Nemus-Project/harpsichord-interface/img/disegno.pdf

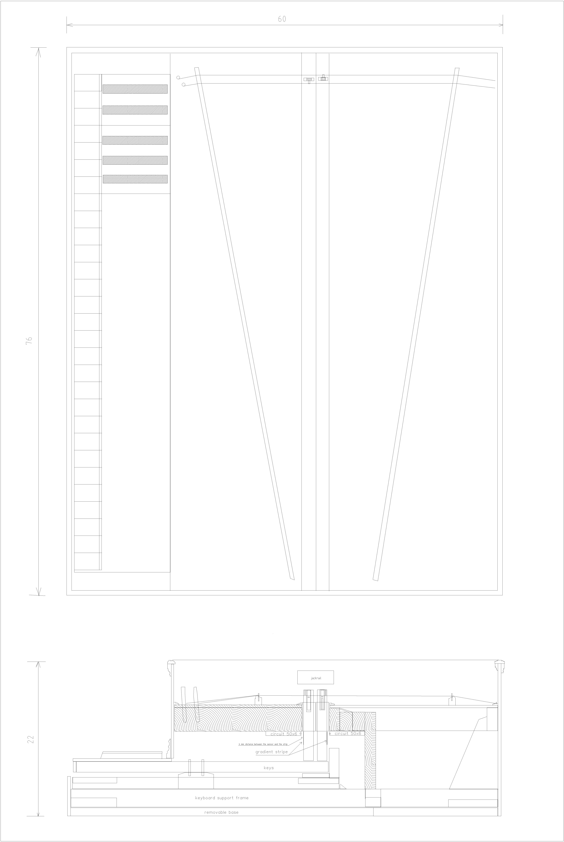
[picture p6: page 1]
