Nemus-Project/harpsichord-interface/docs/img/controller_board.png

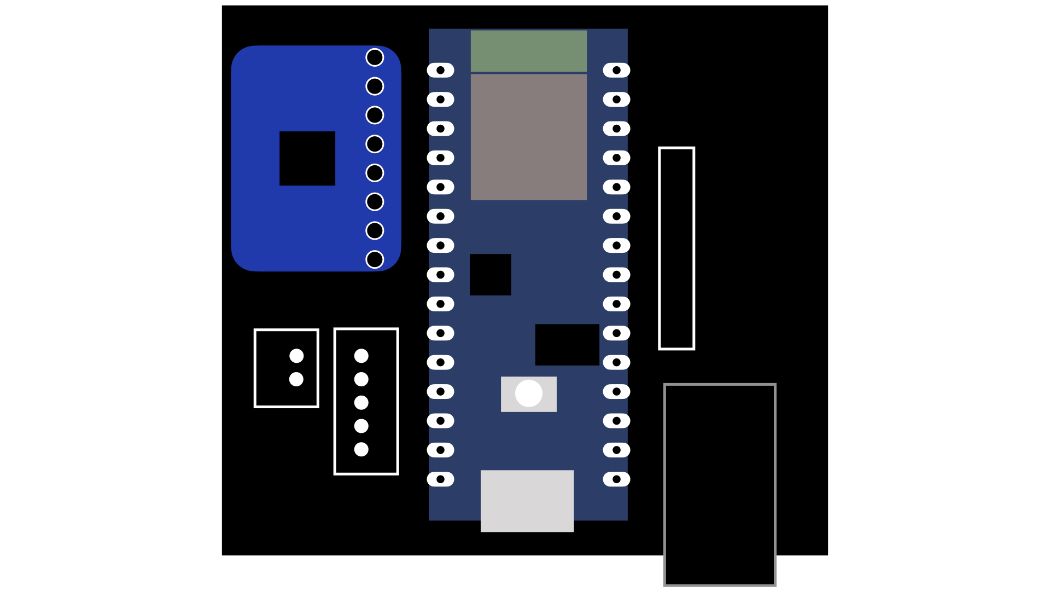
docs/img/controller_board.png
