Nemus-Project/harpsichord-interface/img/7-jack-pcb.jpeg

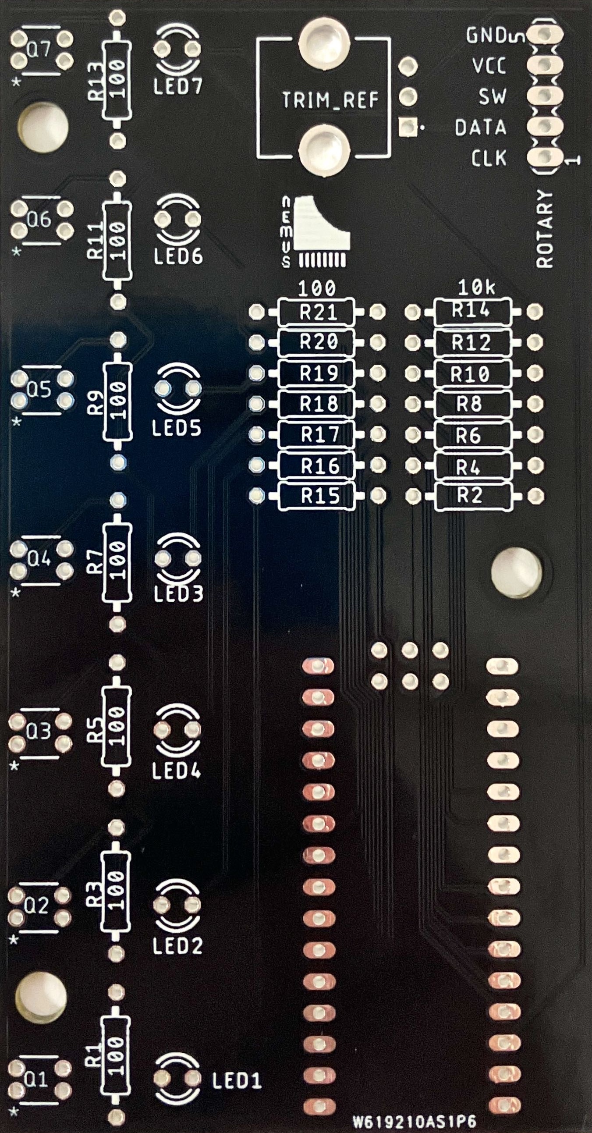
img/7-jack-pcb.jpeg
