Nemus-Project/harpsichord-interface/img/7-jack-pcb.png

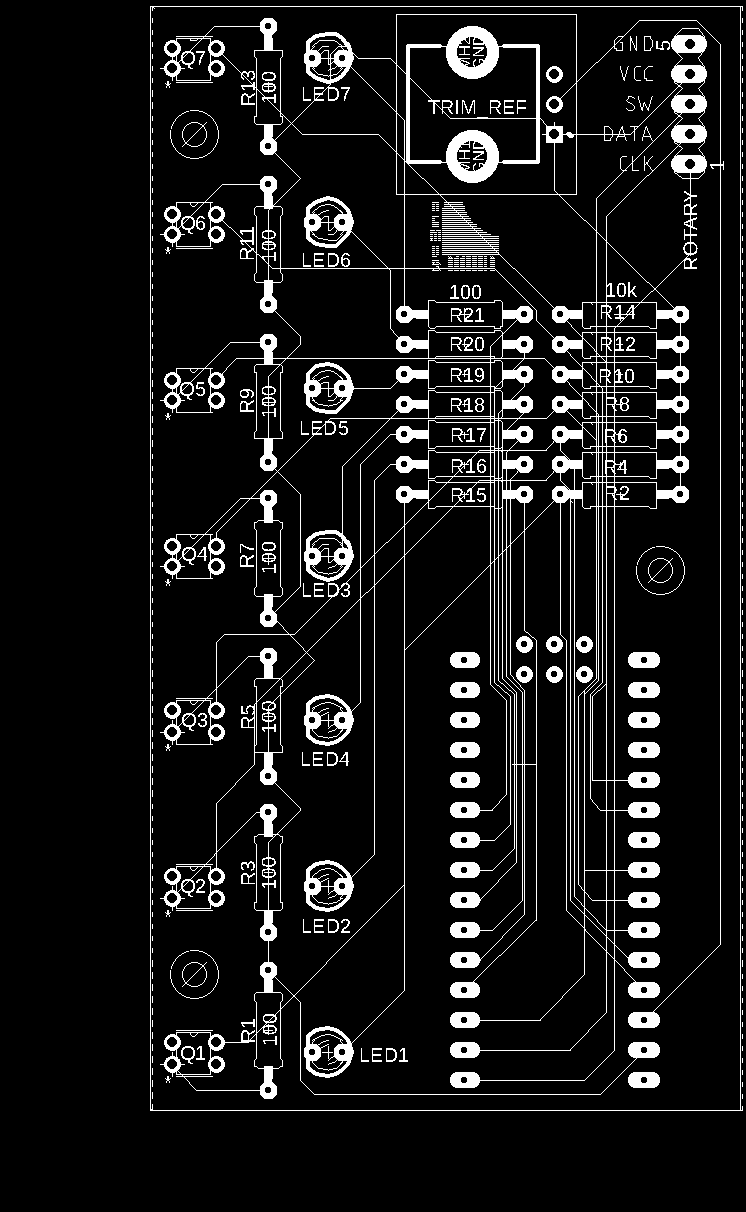
img/7-jack-pcb.png
