Nemus-Project/harpsichord-interface/img/49-key-bottom.jpeg

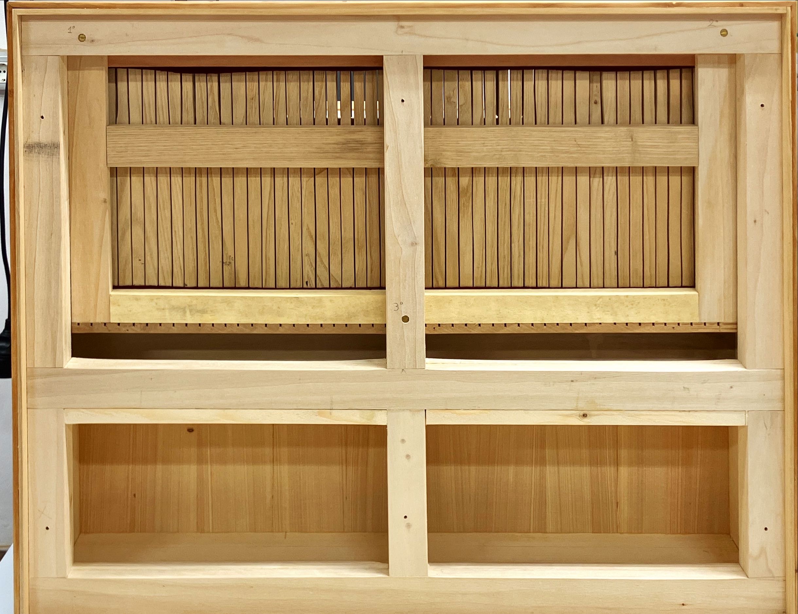
img/49-key-bottom.jpeg
