Nemus-Project/harpsichord-interface/img/49-key-jacks.jpeg

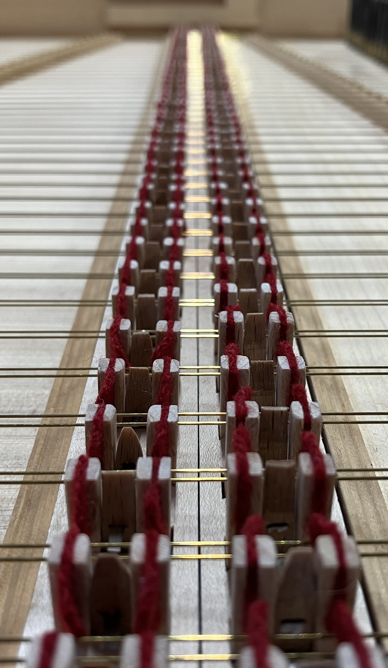
img/49-key-jacks.jpeg
