Nemus-Project/harpsichord-interface/img/CrossSectionSensorPlacement.jpg

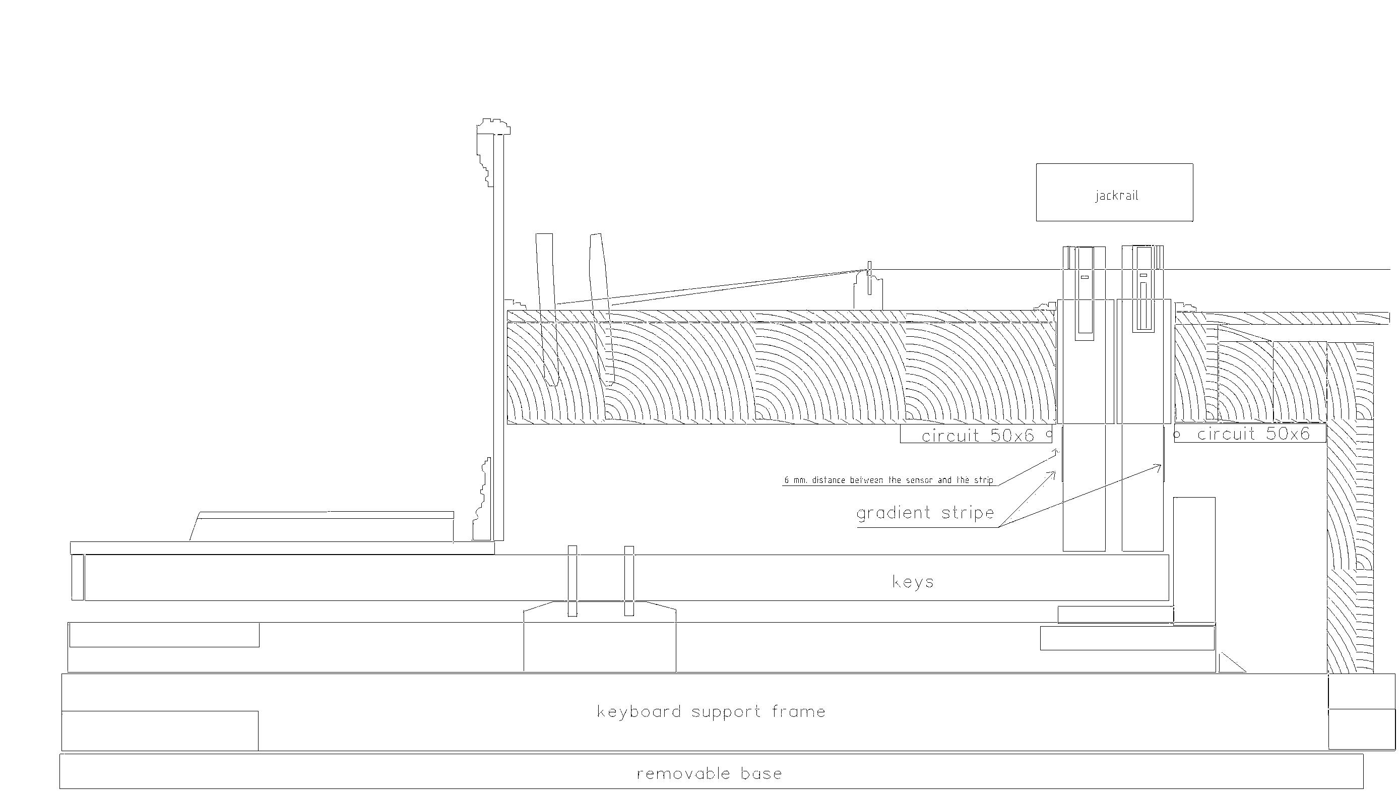
img/CrossSectionSensorPlacement.jpg
