Nemus-Project/harpsichord-interface/img/IMG_1575.jpeg

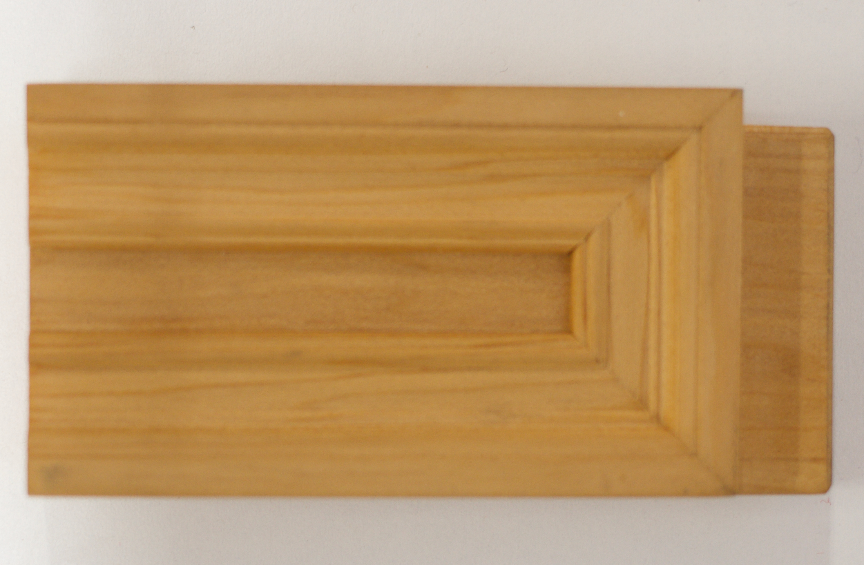
img/IMG_1575.jpeg
