Nemus-Project/harpsichord-interface/img/IMG_1578.jpeg

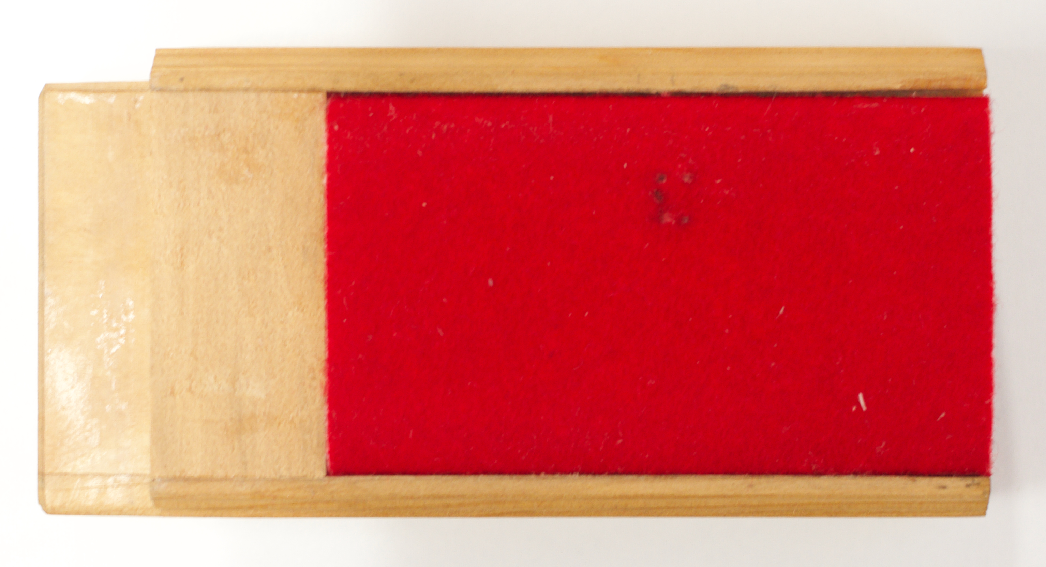
img/IMG_1578.jpeg
