Nemus-Project/harpsichord-interface/img/jack-dimensions-w-slots.png

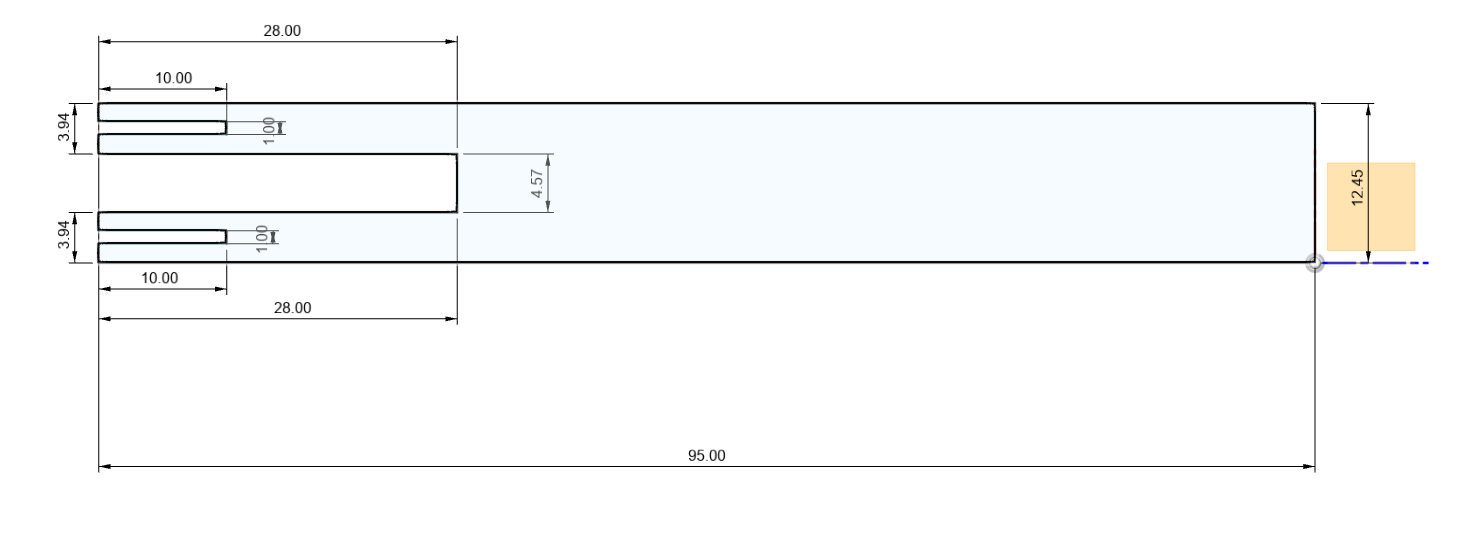
img/jack-dimensions-w-slots.png
