Nemus-Project/harpsichord-interface/img/jack-dimensions.png

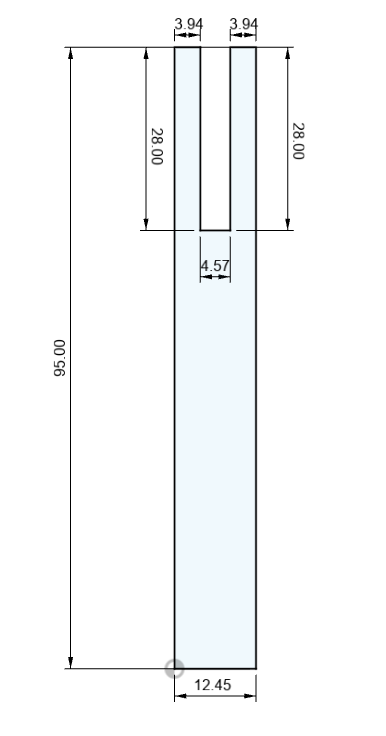
img/jack-dimensions.png
