Nemus-Project/harpsichord-interface/img/jacks.jpg

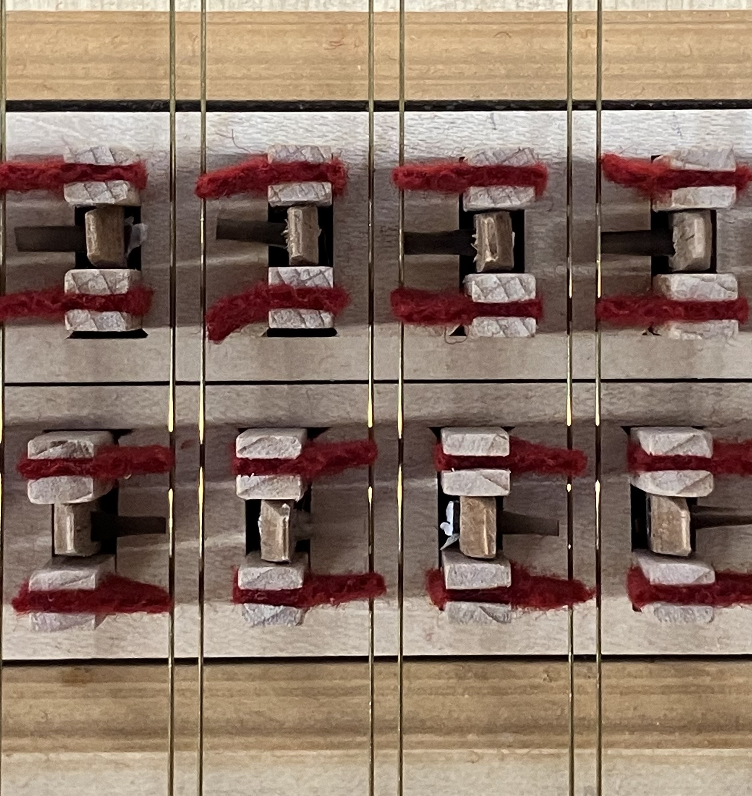
img/jacks.jpg
