Nemus-Project/harpsichord-interface/img/jacks_w_strip_sensor.jpg

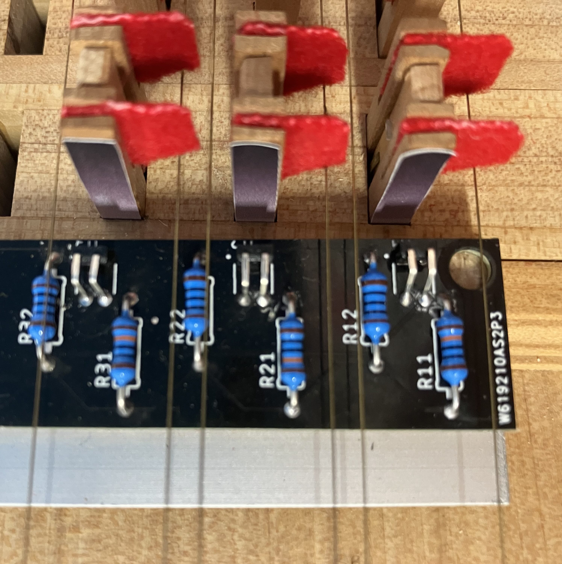
img/jacks_w_strip_sensor.jpg
