Nemus-Project/harpsichord-interface/img/qre1113-dims.png

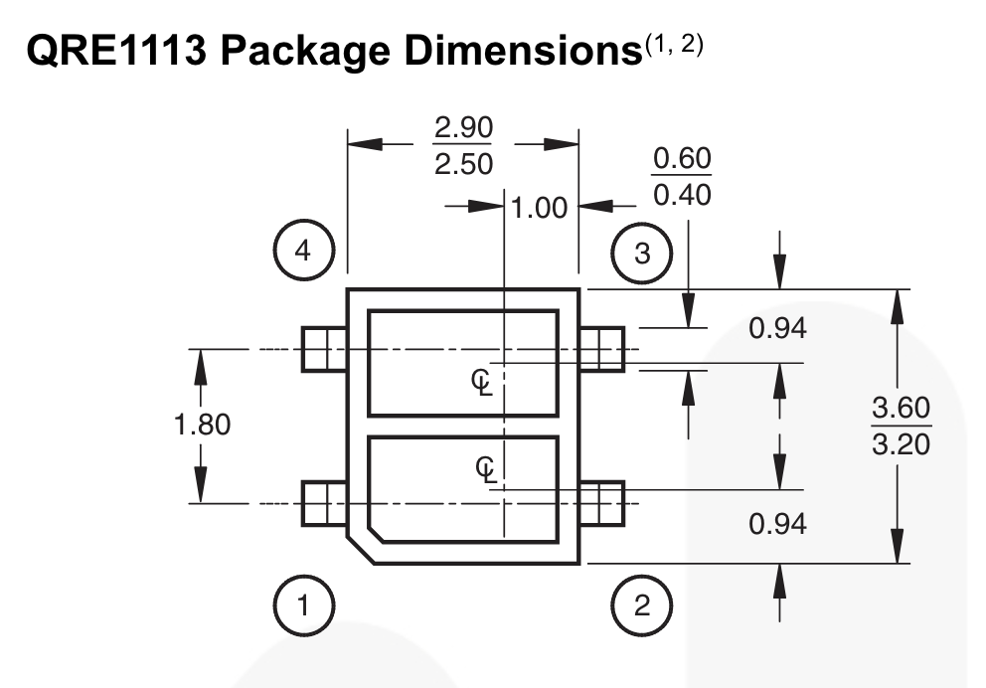
img/qre1113-dims.png
