Nemus-Project/harpsichord-interface/img/qre1113-pins.png

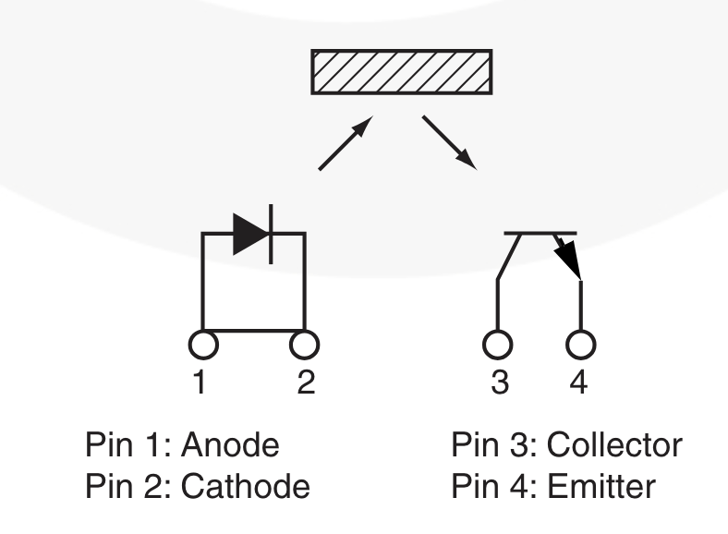
img/qre1113-pins.png
