Nemus-Project/harpsichord-interface/img/3-Key-Jack v18.dxf

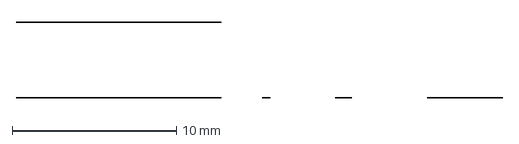
[picture p21: CAD file, 2025-04-11]
img/3-Key-Jack v18.dxf
29.6 x 4.60 mm
