Nemus-Project/harpsichord-interface/docs/img/controller_board_labelled.pdf

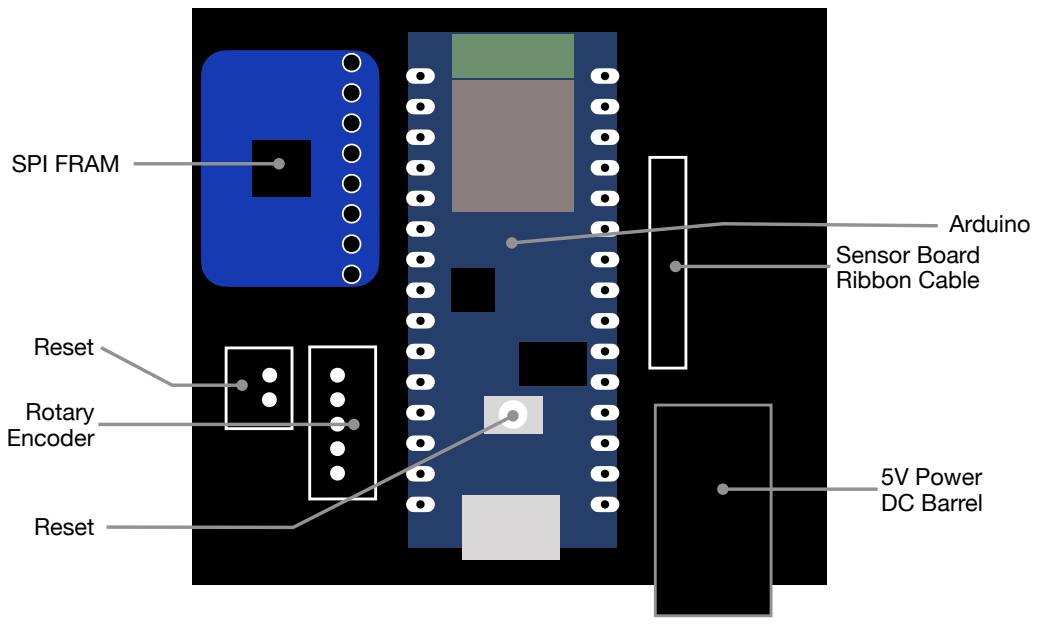
[picture p22: page 1]
Arduino Sensor Board Ribbon Cable; 5V Power DC Barrel; SPI FRAM; Reset; Rotary Encoder
