Nemus-Project/harpsichord-interface/docs/img/controller_board.pdf

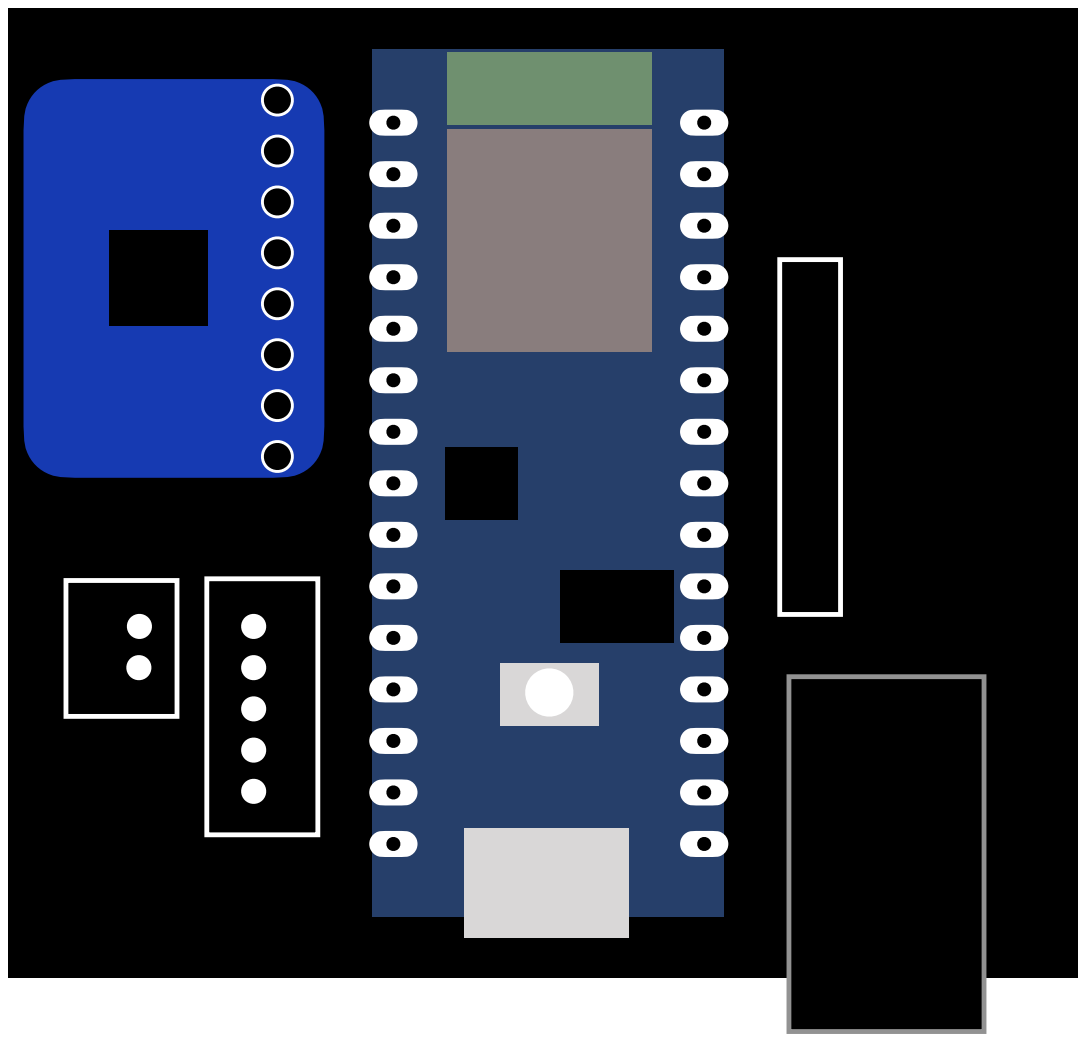
[picture p23: page 1]
